Isioviel/circuitpython-badge/hardware/docs/index.rst

.. Badge documentation master file, created by
   sphinx-quickstart on Sun Aug 19 13:07:17 2018.
   You can adapt this file completely to your liking, but it should at least
   contain the root `toctree` directive.

Welcome to Badge's documentation!
=================================

.. toctree::
    :maxdepth: 2
    :caption: Contents:

    hardware.rst
    library.rst

Indices and tables
==================

* :ref:`genindex`
* :ref:`modindex`
* :ref:`search`
