Isioviel/circuitpython-badge/(list of files, drawings)

Other design files:
hardware/fritzing/badge-full.fzz
